wagiminator/CH32V003-FM-Receiver/documentation/FM_Radio_Receiver_pic7.jpg

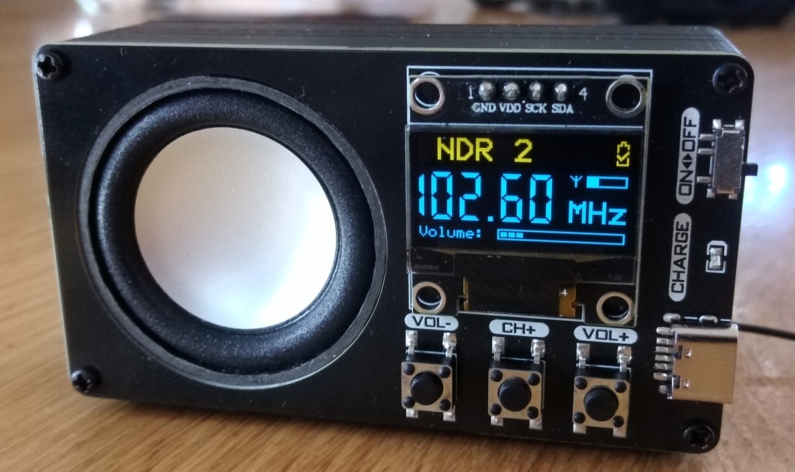
documentation/FM_Radio_Receiver_pic7.jpg
