wagiminator/CH32V003-FM-Receiver/hardware/FM_Radio_Receiver_BOM.tsv

ID | Name | Designator | Footprint | Quantity | Manufacturer Part | Manufacturer | Supplier | Supplier Part
1 | CR123A | B1 | TH_L43.0-W-18.0-CR123A | 1 | CR123A电池座 | null | LCSC | C2803347
2 | 100n | C1,C3,C4,C5 | C_0603 | 4 | CC0603KRX7R9BB104 | YAGEO | LCSC | C14663
3 | 1n | C2 | C_0603 | 1 | CL10B102KB8NNNC | SAMSUNG | LCSC | C1588
4 | 1u | C6,C7 | C_0603 | 2 | CL10A105KB8NNNC | SAMSUNG | LCSC | C15849
5 | 330u | C8 | TANTALUM_CASE-D | 1 | TAJD337M010RNJ | AVX | LCSC | C105408
6 | 10u | C9,C10,C12 | C_0603 | 3 | CL10A106KP8NNNC | SAMSUNG | LCSC | C19702
7 | 4u7 | C11 | C_0603 | 1 | CL10A475KO8NNNC | SAMSUNG | LCSC | C19666
8 | OLED | H1 | I2C OLED 0.96 NEW | 1 | SSD1306 I2C OLED
9 | ANT | H2 | PAD_1 | 1 |  |  | LCSC | C81276
10 | SPK+ | H3 | PAD_1 | 1 |  |  | LCSC | C81276
11 | SPK- | H4 | PAD_1 | 1 |  |  | LCSC | C81276
12 | UPDI | H5 | PAD_3 | 1 | Header2.54mm 1*3P | BOOMELE | LCSC | C49257
13 | BAT | H6 | CONN-SMD_2P_PH2.0_LT | 1 | PH2.0-2P | BOOMELE | LCSC | C64658
14 | SPK | H7 | CONN-SMD_2P_PH2.0_LT | 1 | PH2.0-2P | BOOMELE | LCSC | C64658
15 | VOL+ | KEY1 | KEY-6.0*6.0 | 1 | SMD Tactile Switch6*6*6mm | ReliaPro | LCSC | C23873
16 | CH+ | KEY2 | KEY-6.0*6.0 | 1 | SMD Tactile Switch6*6*6mm | ReliaPro | LCSC | C23873
17 | VOL- | KEY3 | KEY-6.0*6.0 | 1 | SMD Tactile Switch6*6*6mm | ReliaPro | LCSC | C23873
18 | CHARGE | LED1 | LED_0603 | 1 | KT-0603R | KENTO | LCSC | C2286
19 | 10k | R1,R2 | 0603 | 2 | 0603WAF1002T5E | UniOhm | LCSC | C25804
20 | 100k | R3,R4 | 0603 | 2 | 0603WAF1003T5E | UniOhm | LCSC | C25803
21 | 1k | R5 | 0603 | 1 | 0603WAF1001T5E | UniOhm | LCSC | C21190
22 | 2k | R6 | 0603 | 1 | 0603WAF2001T5E | UniOhm | LCSC | C22975
23 | 5k1 | R7,R8 | 0603 | 2 | 0603WAF5101T5E | UniOhm | LCSC | C23186
24 | POWER | SW1 | SW-SMD_SS-1290L-GLL-1.5MM | 1 | SS-1290L-GL L=1.5mm | RI SHENG | LCSC | C695418
25 | CH32V003J4M6 | U1 | SOP-8_150MIL | 1 | CH32V003J4M6 | WCH(Jiangsu Qin Heng) | LCSC | C5346354
26 | RDA5807MP | U2 | SOP-8_150MIL | 1 | RDA5807MP | RDA Microelectronics | LCSC | C167245
27 | TC8871 | U3 | SOP-8_EP_150MIL | 1 | TC8871 | FM | LCSC | C89482
28 | ME6209A33M3G | U4 | SOT-23-3_W | 1 | ME6209A33M3G | MICRONE | LCSC | C83508
29 | TP4054 | U5 | SOT-23-5_BR | 1 | TP4054 | UMW(广东友台半导体) | LCSC | C668215
30 | USB-TYPE-C-6PIN | USB1 | USB-C-SMD-6P | 1 | TYPE-C-31-M-17 | Korean Hroparts Elec | LCSC | C283540
31 | 32.768kHz | X1 | OSC-SMD_3215 | 1 | AH03270014 | TXC Corp | LCSC | C409356
