wagiminator/CH32V003-FM-Receiver/3dprint/FM_Radio_Receiver_case_12mm.fcstd

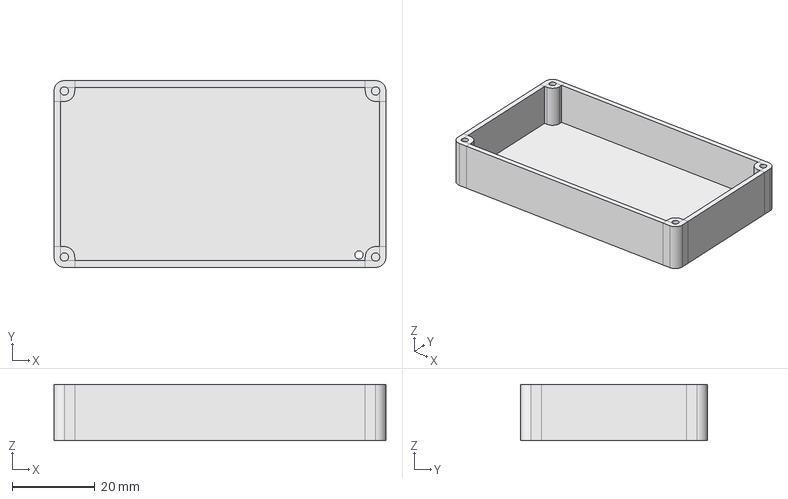
[picture p9: CAD file, 2024-01-07]
3dprint/FM_Radio_Receiver_case_12mm.fcstd
80.0 x 45.0 x 13.6 mm
