wagiminator/CH32V003-FM-Receiver/3dprint/FM_Radio_Receiver_case_30mm.fcstd

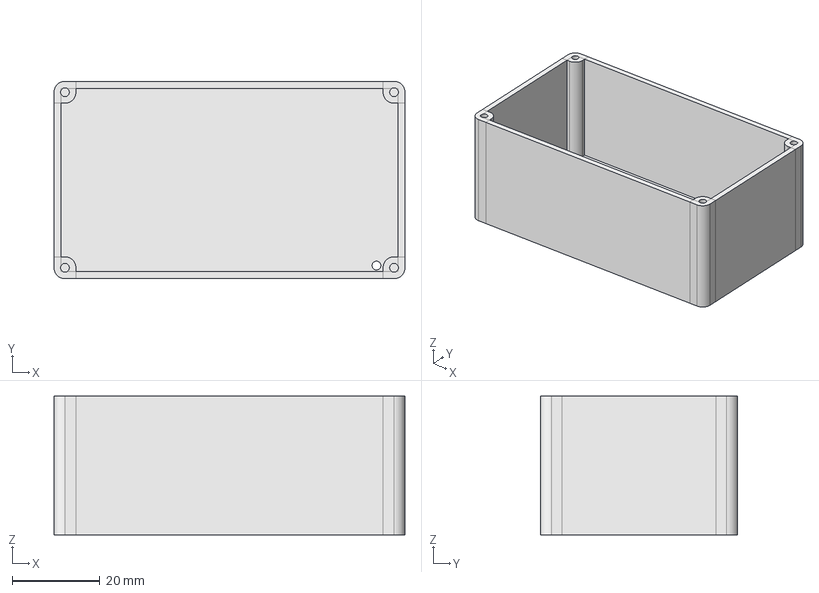
[picture p10: CAD file, 2024-01-07]
3dprint/FM_Radio_Receiver_case_30mm.fcstd
80.0 x 45.0 x 31.6 mm
