wagiminator/CH32V003-FM-Receiver/3dprint/FM_Radio_Receiver_case_20mm.fcstd

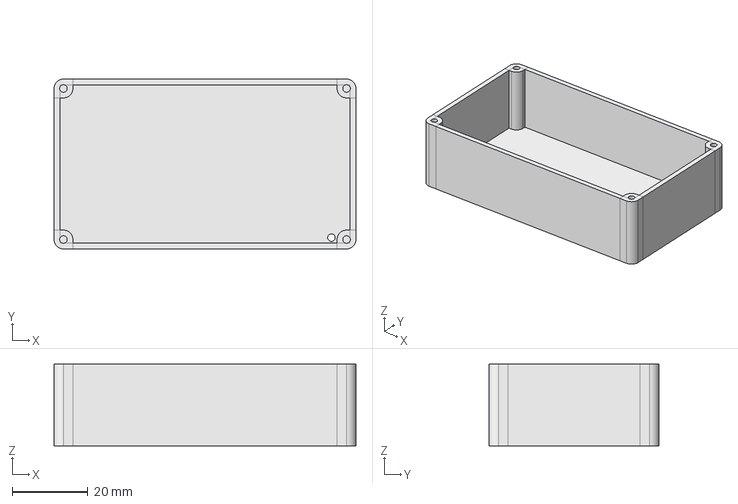
[picture p11: CAD file, 2024-01-07]
3dprint/FM_Radio_Receiver_case_20mm.fcstd
80.0 x 45.0 x 21.6 mm
