wagiminator/CH32V003-FM-Receiver/3dprint/FM_Radio_Receiver_case_25mm.fcstd

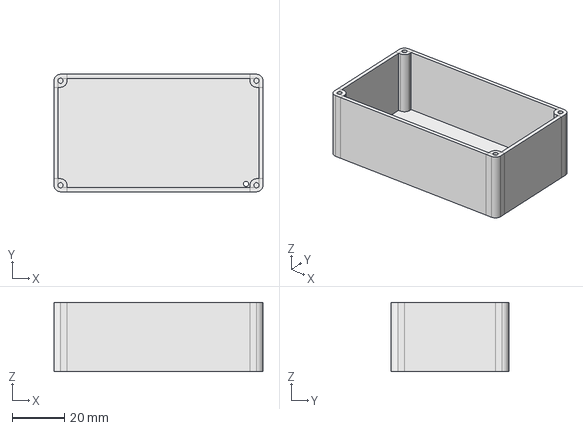
[picture p12: CAD file, 2024-01-07]
3dprint/FM_Radio_Receiver_case_25mm.fcstd
80.0 x 45.0 x 26.6 mm
