wagiminator/CH32V003-FM-Receiver/(list of files, cad)

Other CAD files:
3dprint/FM_Radio_Receiver_case_12mm.stl
3dprint/FM_Radio_Receiver_case_20mm.stl
3dprint/FM_Radio_Receiver_case_25mm.stl
3dprint/FM_Radio_Receiver_case_30mm.stl
