wagiminator/CH32V003-FM-Receiver/(threads)

Thread 1 (2024-01-10):

[Enhancement request] 12-volt DC power source

The-Monkey-King, 2024-01-10:
Would be interested in making this into an FM receiver for an automobile.

wagiminator, 2024-01-10:
I'm not sure I really want this thing in my car ;-)
