wagiminator/CH32V003-FM-Receiver/hardware/FM_Radio_Receiver_schematic.pdf

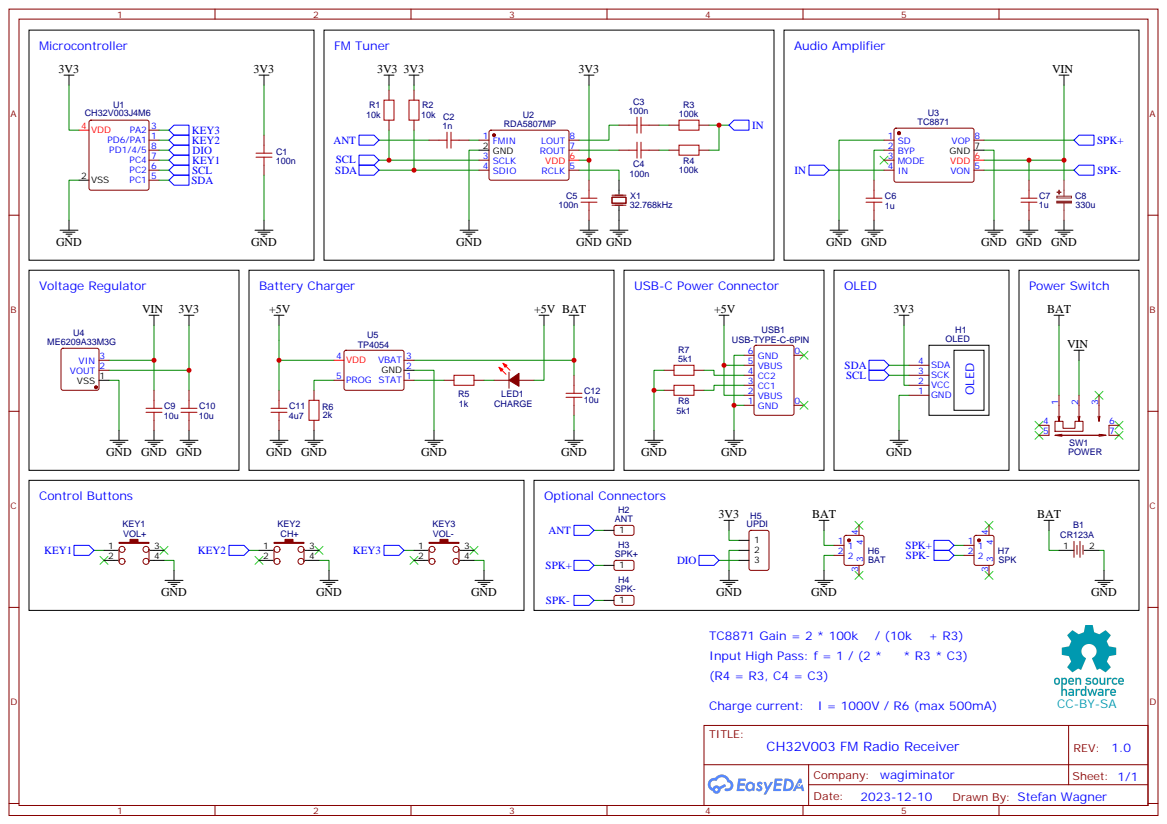
[picture p13: page 1]

Drawn By: Stefan Wagner
