wagiminator/CH32V003-FM-Receiver/software/include/oled_gfx.h

// ===================================================================================
// SSD1306 I2C OLED Graphics Functions                                        * v1.4 *
// ===================================================================================
//
// Functions available:
// --------------------
// OLED_init()                    Init OLED
// OLED_display(v)                Switch display on/off (0: display off, 1: display on)
// OLED_contrast(v)               Set OLED contrast (0-255)
// OLED_invert(v)                 Invert display (0: inverse off, 1: inverse on)
// OLED_flip(xflip,yflip)         Flip display (0: flip off, 1: flip on)
// OLED_vscroll(y)                Scroll display vertically
// OLED_home(x,y)                 Set display home position for screen refresh (0,0)
// OLED_refresh()                 Refresh screen buffer (send buffer via I2C)
//
// OLED_clear()                   Clear OLED screen buffer
// OLED_copy()                    Copy OLED screen buffer (for double-buffer mode)
// OLED_getPixel(x,y)             Get pixel color at (x,y) (0: pixel cleared, 1: pixel set)
// OLED_setPixel(x,y,c)           Set pixel color (c) at position (x,y)
//
// OLED_drawVLine(x,y,h,c)        Draw vertical line starting from (x,y), height (h), color (c)
// OLED_drawHLine(x,y,w,c)        Draw horizontal line starting from (x,y), width (w), color (c)
// OLED_drawLine(x0,y0,x1,y1,c)   Draw line from position (x0,y0) to (x1,y1) with color (c)
//
// OLED_drawRect(x,y,w,h,c)       Draw rectangle starting from (x,y), width (w), height (h), color (c)
// OLED_fillRect(x,y,w,h,c)       Draw filled rectangle starting from (x,y), width (w), height (h), color (c)
// OLED_drawCircle(x,y,r,c)       Draw circle, center at position (x,y), radius (r), color (c)
// OLED_fillCircle(x,y,r,c)       Draw filled circle, center at position (x,y), radius (r), color (c)
//
// OLED_drawScreen(*p)            Draw complete screen, pointer to bitmap (*p)
// OLED_drawBitmap(x,y,w,h,*p)    Draw bitmap at (x,y), width (w), hight (h), pointer to bitmap (*p)
// OLED_drawSprite(x,y,w,h,*p)    Draw sprite at (x,y), width (w), hight (h), pointer to bitmap (*p)
//
// OLED_print(x,y,*st,c,sz)       Print string (*st) at position (x,y), color (c), size (sz)
// OLED_drawChar(x,y,ch,c,sz)     Draw character (ch) at position (x,y), color (c), size (sz)
// OLED_smoothChar(x,y,ch,c)      Draw character (ch) at position (x,y), color (c), double-size smoothed
// OLED_stretchChar(x,y,ch,c)     Draw character (ch) at position (x,y), color (c), v-stretched
//
// If print functions are activated (see below, print.h must be included):
// -----------------------------------------------------------------------
// OLED_cursor(x,y,c,sz)          Set cursor at position (x,y), color (c), size (sz)
// OLED_printf(f, ...)            printf (supports %s, %c, %d, %u, %x, %b, %02d, %%)
// OLED_printD(n)                 Print decimal value
// OLED_printW(n)                 Print 32-bit hex word value
// OLED_printH(n)                 Print 16-bit hex half-word value
// OLED_printB(n)                 Print  8-bit hex byte value
// OLED_printS(s)                 Print string
// OLED_println(s)                Print string with newline
// OLED_newline()                 Send newline
//
// Notes:
// ------
// - color: 0: clear pixel (black), 1: set pixel (white), 2: invert pixel
// - size:  1: normal 6x8 pixels, 2: double size (12x16), ... , 8: 8 times (48x64)
//          9: smoothed double size (12x16), 10: v-stretched (6x16)
//
// References:
// -----------
// - Neven Boyanov:         https://github.com/tinusaur/ssd1306xled
// - Stephen Denne:         https://github.com/datacute/Tiny4kOLED
// - David Johnson-Davies:  http://www.technoblogy.com/show?3AJ7
// - OLED Font Editor:      http://sourpuss.net/projects/fontedit/
//
// 2024 by Stefan Wagner:   https://github.com/wagiminator

#pragma once

#ifdef __cplusplus
extern "C" {
#endif

#include "config.h"
#include "i2c.h"                    // choose your I2C library
#include "system.h"

// OLED parameters
#define OLED_WIDTH        128       // OLED width in pixels
#define OLED_HEIGHT       64        // OLED height in pixels
#define OLED_BOOT_TIME    50        // OLED boot up time in milliseconds
#define OLED_INIT_I2C     0         // 1: init I2C with OLED_init()
#define OLED_FLIP_SCREEN  1         // 1: flip screen with OLED_init()
#define OLED_PORTRAIT     0         // 1: use OLED in portrait mode
#define OLED_DOUBLEBUF    0         // 1: use double buffer
#define OLED_PRINT        0         // 1: include print functions (needs print.h)

// Segment Digit Parameters
#define OLED_SEG_FONT     1         // 0: unused, 1: 13x32 digits, 2: 5x16 digits
#define OLED_SEG_SPACE    5         // width of space between segment digits in pixels

// OLED definitions
#define OLED_ADDR         0x3C      // OLED I2C device address
#define OLED_CMD_MODE     0x00      // set command mode
#define OLED_DAT_MODE     0x40      // set data mode

#define OLED_SMOOTH       9         // character size value for double-size smoothed
#define OLED_STRETCH      10        // character size value for v-stretched

// OLED commands
#define OLED_COLUMN_LOW   0x00      // set lower 4 bits of start column (0x00 - 0x0F)
#define OLED_COLUMN_HIGH  0x10      // set higher 4 bits of start column (0x10 - 0x1F)
#define OLED_MEMORYMODE   0x20      // set memory addressing mode (following byte)
#define OLED_COLUMNS      0x21      // set start and end column (following 2 bytes)
#define OLED_PAGES        0x22      // set start and end page (following 2 bytes)
#define OLED_STARTLINE    0x40      // set display start line (0x40-0x7F = 0-63)
#define OLED_CONTRAST     0x81      // set display contrast (following byte, 0-255)
#define OLED_CHARGEPUMP   0x8D      // (following byte - 0x14:enable, 0x10: disable)
#define OLED_XFLIP_OFF    0xA0      // don't flip display horizontally
#define OLED_XFLIP        0xA1      // flip display horizontally
#define OLED_RESUME       0xA4      // display all on resume
#define OLED_ALL_ON       0xA5      // display all on
#define OLED_INVERT_OFF   0xA6      // set non-inverted display
#define OLED_INVERT       0xA7      // set inverse display
#define OLED_MULTIPLEX    0xA8      // set multiplex ratio (following byte)
#define OLED_DISPLAY_OFF  0xAE      // set display off (sleep mode)
#define OLED_DISPLAY_ON   0xAF      // set display on
#define OLED_PAGE         0xB0      // set start page (0xB0-0xB7 = 0-7)
#define OLED_YFLIP_OFF    0xC0      // don't flip display vertically
#define OLED_YFLIP        0xC8      // flip display vertically
#define OLED_OFFSET       0xD3      // set display offset (y-scroll: following byte)
#define OLED_CLOCK        0xD5      // set frequency (bits 7-4) and divider (bits 3-0)
#define OLED_PRECHARGE    0xD9      // set pre-charge period (following byte)
#define OLED_COMPINS      0xDA      // set COM pin config (following byte)
#define OLED_VCOM_DETECT  0xDB      // set VCOM detect (following byte)

#define OLED_abs(n)       (((n)>=0)?(n):(-(n))) // returns positive value of n

// OLED Screen Buffer
extern uint8_t OLED_buffer[];

#if OLED_DOUBLEBUF > 0
extern uint8_t* OLED_drawbuffer;
extern uint8_t* OLED_sendbuffer;
#endif

// OLED Control Functions
void OLED_init(void);
void OLED_display(uint8_t val);
void OLED_contrast(uint8_t val);
void OLED_invert(uint8_t val);
void OLED_flip(uint8_t xflip, uint8_t yflip);
void OLED_vscroll(uint8_t y);
void OLED_home(uint8_t x, uint8_t y);
void OLED_refresh(void);

// OLED Graphics Functions
void OLED_clear(void);
void OLED_copy(void);
uint8_t OLED_getPixel(int16_t x, int16_t y);
void OLED_setPixel(int16_t x, int16_t y, uint8_t color);
void OLED_drawVLine(int16_t x, int16_t y, int16_t h, uint8_t color);
void OLED_drawHLine(int16_t x, int16_t y, int16_t w, uint8_t color);
void OLED_drawLine(int16_t x0, int16_t y0, int16_t x1, int16_t y1, uint8_t color);
void OLED_drawCircle(int16_t x0, int16_t y0, int16_t r, uint8_t color);
void OLED_fillCircle(int16_t x0, int16_t y0, int16_t r, uint8_t color);
void OLED_drawRect(int16_t x, int16_t y, int16_t w, int16_t h, uint8_t color);
void OLED_fillRect(int16_t x, int16_t y, int16_t w, int16_t h, uint8_t color);
void OLED_drawScreen(const uint8_t* bmp);
void OLED_drawBitmap(int16_t x0, int16_t y0, int16_t w, int16_t h, const uint8_t* bmp);
void OLED_drawSprite(int16_t x0, int16_t y0, int16_t w, int16_t h, const uint8_t* bmp);
void OLED_print(int16_t x, int16_t y, char* str, uint8_t color, uint8_t size);
void OLED_drawChar(int16_t x, int16_t y, char c, uint8_t color, uint8_t size);
void OLED_smoothChar(int16_t x, int16_t y, char c, uint8_t color);
void OLED_stretchChar(int16_t x, int16_t y, char c, uint8_t color);

#if OLED_SEG_FONT > 0
void OLED_printSegment(int16_t x, int16_t y, uint16_t value, uint8_t digits, uint8_t lead, uint8_t decimal);
#endif

// Additional print functions (if activated, see above)
#if OLED_PRINT == 1
#include "print.h"
void OLED_cursor(int16_t x, int16_t y, uint8_t color, uint8_t size);
void OLED_write(char c);
#define OLED_printD(n)        printD(OLED_write, n)   // print decimal as string
#define OLED_printW(n)        printW(OLED_write, n)   // print word as string
#define OLED_printH(n)        printH(OLED_write, n)   // print half-word as string
#define OLED_printB(n)        printB(OLED_write, n)   // print byte as string
#define OLED_printS(s)        printS(OLED_write, s)   // print string
#define OLED_println(s)       println(OLED_write, s)  // print string with newline
#define OLED_newline()        OLED_write('\n')        // send newline
#define OLED_printf(f, ...)   printF(OLED_write, f, ##__VA_ARGS__)
#endif

#ifdef __cplusplus
};
#endif
